wangk2017/krv_m0/(list of files, cad)

Other CAD files:
FPGA_PROGRAMMING_DATA/krv_m.stp
