wangk2017/krv_m0/src/rtl/core/imem_ctrl.v

/*
 Licensed under the Apache License, Version 2.0 (the "License");         
 you may not use this file except in compliance with the License.        
 You may obtain a copy of the License at                                 
                                                                         
     http://www.apache.org/licenses/LICENSE-2.0                          
                                                                         
  Unless required by applicable law or agreed to in writing, software    
 distributed under the License is distributed on an "AS IS" BASIS,       
 WITHOUT WARRANTIES OR CONDITIONS OF ANY KIND, either express or implied.
 See the License for the specific language governing permissions and     
 limitations under the License.      
*/

//==============================================================||
// File Name: 		mem_ctrl.v				||
// Author:    		Kitty Wang				||
// Description: 						||
//	      		instruction memory control block        ||
// History:   							||
//                      2017/9/26 				||
//                      First version				||
//===============================================================

`include "top_defines.vh"
`include "core_defines.vh"
module imem_ctrl (
//global signals
input wire cpu_clk,					//cpu clock
input wire cpu_rstn,					//cpu reset, active low

//interface with fetch
input wire [`ADDR_WIDTH - 1 : 0] next_pc,			//next_pc
input wire [`ADDR_WIDTH - 1 : 0] pc,				//pc
output wire [`INSTR_WIDTH - 1 : 0] instr_read_data,  	//instruction
output wire instr_read_data_valid,			//instruction valid
output wire addr_AHB,

//interface with ITCM
output wire instr_itcm_access,				//ITCM access
output wire [`ADDR_WIDTH - 1 : 0] instr_itcm_addr,	//ITCM access address
input wire [`INSTR_WIDTH - 1 : 0] instr_itcm_read_data,	//ITCM read data
input wire instr_itcm_read_data_valid,			//ITCM read data valid
input wire itcm_auto_load,			//ITCM is in auto-load process

//interface with DTCM
input wire dtcm_en,					//DTCM enable
input wire [`ADDR_WIDTH - 1 : 0] dtcm_start_addr,	//DTCM start address
output instr_dtcm_access,				//DTCM access signal
output [`ADDR_WIDTH - 1 : 0] instr_dtcm_addr,		//DTCM access address
input wire [`DATA_WIDTH - 1 : 0] instr_dtcm_read_data,	//DTCM read data
input wire instr_dtcm_read_data_valid,			//DTCM read data valid

//interface with IAHB
output wire IAHB_access,				//IAHB access 
output wire [`ADDR_WIDTH - 1 : 0] IAHB_addr,		//IAHB access address
input wire [`INSTR_WIDTH - 1 : 0] IAHB_read_data,	//IAHB read data
input wire IAHB_read_data_valid				//IAHB read data valid
);


//NOTE: memory access should be aligned for now!

//---------------------------------------------//
//address decoder
//---------------------------------------------//
wire addr_itcm;
wire addr_dtcm;
assign addr_itcm =(next_pc >= `ITCM_START_ADDR) && (next_pc < `ITCM_START_ADDR + `ITCM_SIZE);
assign addr_dtcm = dtcm_en && ( (next_pc < dtcm_start_addr + `DTCM_SIZE) && (next_pc >= dtcm_start_addr));
assign addr_AHB = ~(addr_itcm | addr_dtcm);

reg addr_itcm_r;
reg addr_dtcm_r;
reg addr_AHB_r;

always @ (posedge cpu_clk or negedge cpu_rstn)
begin
	if(!cpu_rstn)
	begin
		addr_itcm_r <= 1'b0;
		addr_dtcm_r <= 1'b0;
		addr_AHB_r <= 1'b0;
	end
	else
	begin
		addr_itcm_r <= addr_itcm;
		addr_dtcm_r <= addr_dtcm;
		addr_AHB_r <= addr_AHB;
	end
end

//---------------------------------------------//
//Drive interface
//---------------------------------------------//
assign instr_itcm_access = addr_itcm;
assign instr_itcm_addr = next_pc;

assign instr_dtcm_access = addr_dtcm;
assign instr_dtcm_addr = next_pc;

assign IAHB_access = addr_AHB_r;
assign IAHB_addr = pc;
 
//---------------------------------------------//
//read data MUX 
//---------------------------------------------//
assign instr_read_data = ({`INSTR_WIDTH{(addr_itcm_r & instr_itcm_read_data_valid)}} & instr_itcm_read_data)
			|({`INSTR_WIDTH{(addr_dtcm_r & instr_dtcm_read_data_valid)}} & instr_dtcm_read_data) 
			|({`INSTR_WIDTH{(!itcm_auto_load & addr_AHB_r &  IAHB_read_data_valid)}} & IAHB_read_data);
assign instr_read_data_valid = (addr_itcm_r && instr_itcm_read_data_valid) || (addr_dtcm_r && instr_dtcm_read_data_valid) || (!itcm_auto_load && addr_AHB_r && IAHB_read_data_valid);

endmodule
