wangk2017/krv_m0/src/component/work/flash_ss_MSS/flash_ss_MSS_pre.v

`timescale 1 ns/100 ps
// Version: 


module MSS_025(
       CAN_RXBUS_MGPIO3A_H2F_A,
       CAN_RXBUS_MGPIO3A_H2F_B,
       CAN_TX_EBL_MGPIO4A_H2F_A,
       CAN_TX_EBL_MGPIO4A_H2F_B,
       CAN_TXBUS_MGPIO2A_H2F_A,
       CAN_TXBUS_MGPIO2A_H2F_B,
       CLK_CONFIG_APB,
       COMMS_INT,
       CONFIG_PRESET_N,
       EDAC_ERROR,
       F_FM0_RDATA,
       F_FM0_READYOUT,
       F_FM0_RESP,
       F_HM0_ADDR,
       F_HM0_ENABLE,
       F_HM0_SEL,
       F_HM0_SIZE,
       F_HM0_TRANS1,
       F_HM0_WDATA,
       F_HM0_WRITE,
       FAB_CHRGVBUS,
       FAB_DISCHRGVBUS,
       FAB_DMPULLDOWN,
       FAB_DPPULLDOWN,
       FAB_DRVVBUS,
       FAB_IDPULLUP,
       FAB_OPMODE,
       FAB_SUSPENDM,
       FAB_TERMSEL,
       FAB_TXVALID,
       FAB_VCONTROL,
       FAB_VCONTROLLOADM,
       FAB_XCVRSEL,
       FAB_XDATAOUT,
       FACC_GLMUX_SEL,
       FIC32_0_MASTER,
       FIC32_1_MASTER,
       FPGA_RESET_N,
       GTX_CLK,
       H2F_INTERRUPT,
       H2F_NMI,
       H2FCALIB,
       I2C0_SCL_MGPIO31B_H2F_A,
       I2C0_SCL_MGPIO31B_H2F_B,
       I2C0_SDA_MGPIO30B_H2F_A,
       I2C0_SDA_MGPIO30B_H2F_B,
       I2C1_SCL_MGPIO1A_H2F_A,
       I2C1_SCL_MGPIO1A_H2F_B,
       I2C1_SDA_MGPIO0A_H2F_A,
       I2C1_SDA_MGPIO0A_H2F_B,
       MDCF,
       MDOENF,
       MDOF,
       MMUART0_CTS_MGPIO19B_H2F_A,
       MMUART0_CTS_MGPIO19B_H2F_B,
       MMUART0_DCD_MGPIO22B_H2F_A,
       MMUART0_DCD_MGPIO22B_H2F_B,
       MMUART0_DSR_MGPIO20B_H2F_A,
       MMUART0_DSR_MGPIO20B_H2F_B,
       MMUART0_DTR_MGPIO18B_H2F_A,
       MMUART0_DTR_MGPIO18B_H2F_B,
       MMUART0_RI_MGPIO21B_H2F_A,
       MMUART0_RI_MGPIO21B_H2F_B,
       MMUART0_RTS_MGPIO17B_H2F_A,
       MMUART0_RTS_MGPIO17B_H2F_B,
       MMUART0_RXD_MGPIO28B_H2F_A,
       MMUART0_RXD_MGPIO28B_H2F_B,
       MMUART0_SCK_MGPIO29B_H2F_A,
       MMUART0_SCK_MGPIO29B_H2F_B,
       MMUART0_TXD_MGPIO27B_H2F_A,
       MMUART0_TXD_MGPIO27B_H2F_B,
       MMUART1_DTR_MGPIO12B_H2F_A,
       MMUART1_RTS_MGPIO11B_H2F_A,
       MMUART1_RTS_MGPIO11B_H2F_B,
       MMUART1_RXD_MGPIO26B_H2F_A,
       MMUART1_RXD_MGPIO26B_H2F_B,
       MMUART1_SCK_MGPIO25B_H2F_A,
       MMUART1_SCK_MGPIO25B_H2F_B,
       MMUART1_TXD_MGPIO24B_H2F_A,
       MMUART1_TXD_MGPIO24B_H2F_B,
       MPLL_LOCK,
       PER2_FABRIC_PADDR,
       PER2_FABRIC_PENABLE,
       PER2_FABRIC_PSEL,
       PER2_FABRIC_PWDATA,
       PER2_FABRIC_PWRITE,
       RTC_MATCH,
       SLEEPDEEP,
       SLEEPHOLDACK,
       SLEEPING,
       SMBALERT_NO0,
       SMBALERT_NO1,
       SMBSUS_NO0,
       SMBSUS_NO1,
       SPI0_CLK_OUT,
       SPI0_SDI_MGPIO5A_H2F_A,
       SPI0_SDI_MGPIO5A_H2F_B,
       SPI0_SDO_MGPIO6A_H2F_A,
       SPI0_SDO_MGPIO6A_H2F_B,
       SPI0_SS0_MGPIO7A_H2F_A,
       SPI0_SS0_MGPIO7A_H2F_B,
       SPI0_SS1_MGPIO8A_H2F_A,
       SPI0_SS1_MGPIO8A_H2F_B,
       SPI0_SS2_MGPIO9A_H2F_A,
       SPI0_SS2_MGPIO9A_H2F_B,
       SPI0_SS3_MGPIO10A_H2F_A,
       SPI0_SS3_MGPIO10A_H2F_B,
       SPI0_SS4_MGPIO19A_H2F_A,
       SPI0_SS5_MGPIO20A_H2F_A,
       SPI0_SS6_MGPIO21A_H2F_A,
       SPI0_SS7_MGPIO22A_H2F_A,
       SPI1_CLK_OUT,
       SPI1_SDI_MGPIO11A_H2F_A,
       SPI1_SDI_MGPIO11A_H2F_B,
       SPI1_SDO_MGPIO12A_H2F_A,
       SPI1_SDO_MGPIO12A_H2F_B,
       SPI1_SS0_MGPIO13A_H2F_A,
       SPI1_SS0_MGPIO13A_H2F_B,
       SPI1_SS1_MGPIO14A_H2F_A,
       SPI1_SS1_MGPIO14A_H2F_B,
       SPI1_SS2_MGPIO15A_H2F_A,
       SPI1_SS2_MGPIO15A_H2F_B,
       SPI1_SS3_MGPIO16A_H2F_A,
       SPI1_SS3_MGPIO16A_H2F_B,
       SPI1_SS4_MGPIO17A_H2F_A,
       SPI1_SS5_MGPIO18A_H2F_A,
       SPI1_SS6_MGPIO23A_H2F_A,
       SPI1_SS7_MGPIO24A_H2F_A,
       TCGF,
       TRACECLK,
       TRACEDATA,
       TX_CLK,
       TX_ENF,
       TX_ERRF,
       TXCTL_EN_RIF,
       TXD_RIF,
       TXDF,
       TXEV,
       WDOGTIMEOUT,
       F_ARREADY_HREADYOUT1,
       F_AWREADY_HREADYOUT0,
       F_BID,
       F_BRESP_HRESP0,
       F_BVALID,
       F_RDATA_HRDATA01,
       F_RID,
       F_RLAST,
       F_RRESP_HRESP1,
       F_RVALID,
       F_WREADY,
       MDDR_FABRIC_PRDATA,
       MDDR_FABRIC_PREADY,
       MDDR_FABRIC_PSLVERR,
       CAN_RXBUS_F2H_SCP,
       CAN_TX_EBL_F2H_SCP,
       CAN_TXBUS_F2H_SCP,
       COLF,
       CRSF,
       F2_DMAREADY,
       F2H_INTERRUPT,
       F2HCALIB,
       F_DMAREADY,
       F_FM0_ADDR,
       F_FM0_ENABLE,
       F_FM0_MASTLOCK,
       F_FM0_READY,
       F_FM0_SEL,
       F_FM0_SIZE,
       F_FM0_TRANS1,
       F_FM0_WDATA,
       F_FM0_WRITE,
       F_HM0_RDATA,
       F_HM0_READY,
       F_HM0_RESP,
       FAB_AVALID,
       FAB_HOSTDISCON,
       FAB_IDDIG,
       FAB_LINESTATE,
       FAB_M3_RESET_N,
       FAB_PLL_LOCK,
       FAB_RXACTIVE,
       FAB_RXERROR,
       FAB_RXVALID,
       FAB_RXVALIDH,
       FAB_SESSEND,
       FAB_TXREADY,
       FAB_VBUSVALID,
       FAB_VSTATUS,
       FAB_XDATAIN,
       GTX_CLKPF,
       I2C0_BCLK,
       I2C0_SCL_F2H_SCP,
       I2C0_SDA_F2H_SCP,
       I2C1_BCLK,
       I2C1_SCL_F2H_SCP,
       I2C1_SDA_F2H_SCP,
       MDIF,
       MGPIO0A_F2H_GPIN,
       MGPIO10A_F2H_GPIN,
       MGPIO11A_F2H_GPIN,
       MGPIO11B_F2H_GPIN,
       MGPIO12A_F2H_GPIN,
       MGPIO13A_F2H_GPIN,
       MGPIO14A_F2H_GPIN,
       MGPIO15A_F2H_GPIN,
       MGPIO16A_F2H_GPIN,
       MGPIO17B_F2H_GPIN,
       MGPIO18B_F2H_GPIN,
       MGPIO19B_F2H_GPIN,
       MGPIO1A_F2H_GPIN,
       MGPIO20B_F2H_GPIN,
       MGPIO21B_F2H_GPIN,
       MGPIO22B_F2H_GPIN,
       MGPIO24B_F2H_GPIN,
       MGPIO25B_F2H_GPIN,
       MGPIO26B_F2H_GPIN,
       MGPIO27B_F2H_GPIN,
       MGPIO28B_F2H_GPIN,
       MGPIO29B_F2H_GPIN,
       MGPIO2A_F2H_GPIN,
       MGPIO30B_F2H_GPIN,
       MGPIO31B_F2H_GPIN,
       MGPIO3A_F2H_GPIN,
       MGPIO4A_F2H_GPIN,
       MGPIO5A_F2H_GPIN,
       MGPIO6A_F2H_GPIN,
       MGPIO7A_F2H_GPIN,
       MGPIO8A_F2H_GPIN,
       MGPIO9A_F2H_GPIN,
       MMUART0_CTS_F2H_SCP,
       MMUART0_DCD_F2H_SCP,
       MMUART0_DSR_F2H_SCP,
       MMUART0_DTR_F2H_SCP,
       MMUART0_RI_F2H_SCP,
       MMUART0_RTS_F2H_SCP,
       MMUART0_RXD_F2H_SCP,
       MMUART0_SCK_F2H_SCP,
       MMUART0_TXD_F2H_SCP,
       MMUART1_CTS_F2H_SCP,
       MMUART1_DCD_F2H_SCP,
       MMUART1_DSR_F2H_SCP,
       MMUART1_RI_F2H_SCP,
       MMUART1_RTS_F2H_SCP,
       MMUART1_RXD_F2H_SCP,
       MMUART1_SCK_F2H_SCP,
       MMUART1_TXD_F2H_SCP,
       PER2_FABRIC_PRDATA,
       PER2_FABRIC_PREADY,
       PER2_FABRIC_PSLVERR,
       RCGF,
       RX_CLKPF,
       RX_DVF,
       RX_ERRF,
       RX_EV,
       RXDF,
       SLEEPHOLDREQ,
       SMBALERT_NI0,
       SMBALERT_NI1,
       SMBSUS_NI0,
       SMBSUS_NI1,
       SPI0_CLK_IN,
       SPI0_SDI_F2H_SCP,
       SPI0_SDO_F2H_SCP,
       SPI0_SS0_F2H_SCP,
       SPI0_SS1_F2H_SCP,
       SPI0_SS2_F2H_SCP,
       SPI0_SS3_F2H_SCP,
       SPI1_CLK_IN,
       SPI1_SDI_F2H_SCP,
       SPI1_SDO_F2H_SCP,
       SPI1_SS0_F2H_SCP,
       SPI1_SS1_F2H_SCP,
       SPI1_SS2_F2H_SCP,
       SPI1_SS3_F2H_SCP,
       TX_CLKPF,
       USER_MSS_GPIO_RESET_N,
       USER_MSS_RESET_N,
       XCLK_FAB,
       CLK_BASE,
       CLK_MDDR_APB,
       F_ARADDR_HADDR1,
       F_ARBURST_HTRANS1,
       F_ARID_HSEL1,
       F_ARLEN_HBURST1,
       F_ARLOCK_HMASTLOCK1,
       F_ARSIZE_HSIZE1,
       F_ARVALID_HWRITE1,
       F_AWADDR_HADDR0,
       F_AWBURST_HTRANS0,
       F_AWID_HSEL0,
       F_AWLEN_HBURST0,
       F_AWLOCK_HMASTLOCK0,
       F_AWSIZE_HSIZE0,
       F_AWVALID_HWRITE0,
       F_BREADY,
       F_RMW_AXI,
       F_RREADY,
       F_WDATA_HWDATA01,
       F_WID_HREADY01,
       F_WLAST,
       F_WSTRB,
       F_WVALID,
       FPGA_MDDR_ARESET_N,
       MDDR_FABRIC_PADDR,
       MDDR_FABRIC_PENABLE,
       MDDR_FABRIC_PSEL,
       MDDR_FABRIC_PWDATA,
       MDDR_FABRIC_PWRITE,
       PRESET_N,
       CAN_RXBUS_USBA_DATA1_MGPIO3A_IN,
       CAN_TX_EBL_USBA_DATA2_MGPIO4A_IN,
       CAN_TXBUS_USBA_DATA0_MGPIO2A_IN,
       DM_IN,
       DRAM_DQ_IN,
       DRAM_DQS_IN,
       DRAM_FIFO_WE_IN,
       I2C0_SCL_USBC_DATA1_MGPIO31B_IN,
       I2C0_SDA_USBC_DATA0_MGPIO30B_IN,
       I2C1_SCL_USBA_DATA4_MGPIO1A_IN,
       I2C1_SDA_USBA_DATA3_MGPIO0A_IN,
       MGPIO25A_IN,
       MGPIO26A_IN,
       MMUART0_CTS_USBC_DATA7_MGPIO19B_IN,
       MMUART0_DCD_MGPIO22B_IN,
       MMUART0_DSR_MGPIO20B_IN,
       MMUART0_DTR_USBC_DATA6_MGPIO18B_IN,
       MMUART0_RI_MGPIO21B_IN,
       MMUART0_RTS_USBC_DATA5_MGPIO17B_IN,
       MMUART0_RXD_USBC_STP_MGPIO28B_IN,
       MMUART0_SCK_USBC_NXT_MGPIO29B_IN,
       MMUART0_TXD_USBC_DIR_MGPIO27B_IN,
       MMUART1_CTS_MGPIO13B_IN,
       MMUART1_DCD_MGPIO16B_IN,
       MMUART1_DSR_MGPIO14B_IN,
       MMUART1_DTR_MGPIO12B_IN,
       MMUART1_RI_MGPIO15B_IN,
       MMUART1_RTS_MGPIO11B_IN,
       MMUART1_RXD_USBC_DATA3_MGPIO26B_IN,
       MMUART1_SCK_USBC_DATA4_MGPIO25B_IN,
       MMUART1_TXD_USBC_DATA2_MGPIO24B_IN,
       RGMII_GTX_CLK_RMII_CLK_USBB_XCLK_IN,
       RGMII_MDC_RMII_MDC_IN,
       RGMII_MDIO_RMII_MDIO_USBB_DATA7_IN,
       RGMII_RX_CLK_IN,
       RGMII_RX_CTL_RMII_CRS_DV_USBB_DATA2_IN,
       RGMII_RXD0_RMII_RXD0_USBB_DATA0_IN,
       RGMII_RXD1_RMII_RXD1_USBB_DATA1_IN,
       RGMII_RXD2_RMII_RX_ER_USBB_DATA3_IN,
       RGMII_RXD3_USBB_DATA4_IN,
       RGMII_TX_CLK_IN,
       RGMII_TX_CTL_RMII_TX_EN_USBB_NXT_IN,
       RGMII_TXD0_RMII_TXD0_USBB_DIR_IN,
       RGMII_TXD1_RMII_TXD1_USBB_STP_IN,
       RGMII_TXD2_USBB_DATA5_IN,
       RGMII_TXD3_USBB_DATA6_IN,
       SPI0_SCK_USBA_XCLK_IN,
       SPI0_SDI_USBA_DIR_MGPIO5A_IN,
       SPI0_SDO_USBA_STP_MGPIO6A_IN,
       SPI0_SS0_USBA_NXT_MGPIO7A_IN,
       SPI0_SS1_USBA_DATA5_MGPIO8A_IN,
       SPI0_SS2_USBA_DATA6_MGPIO9A_IN,
       SPI0_SS3_USBA_DATA7_MGPIO10A_IN,
       SPI0_SS4_MGPIO19A_IN,
       SPI0_SS5_MGPIO20A_IN,
       SPI0_SS6_MGPIO21A_IN,
       SPI0_SS7_MGPIO22A_IN,
       SPI1_SCK_IN,
       SPI1_SDI_MGPIO11A_IN,
       SPI1_SDO_MGPIO12A_IN,
       SPI1_SS0_MGPIO13A_IN,
       SPI1_SS1_MGPIO14A_IN,
       SPI1_SS2_MGPIO15A_IN,
       SPI1_SS3_MGPIO16A_IN,
       SPI1_SS4_MGPIO17A_IN,
       SPI1_SS5_MGPIO18A_IN,
       SPI1_SS6_MGPIO23A_IN,
       SPI1_SS7_MGPIO24A_IN,
       USBC_XCLK_IN,
       CAN_RXBUS_USBA_DATA1_MGPIO3A_OUT,
       CAN_TX_EBL_USBA_DATA2_MGPIO4A_OUT,
       CAN_TXBUS_USBA_DATA0_MGPIO2A_OUT,
       DRAM_ADDR,
       DRAM_BA,
       DRAM_CASN,
       DRAM_CKE,
       DRAM_CLK,
       DRAM_CSN,
       DRAM_DM_RDQS_OUT,
       DRAM_DQ_OUT,
       DRAM_DQS_OUT,
       DRAM_FIFO_WE_OUT,
       DRAM_ODT,
       DRAM_RASN,
       DRAM_RSTN,
       DRAM_WEN,
       I2C0_SCL_USBC_DATA1_MGPIO31B_OUT,
       I2C0_SDA_USBC_DATA0_MGPIO30B_OUT,
       I2C1_SCL_USBA_DATA4_MGPIO1A_OUT,
       I2C1_SDA_USBA_DATA3_MGPIO0A_OUT,
       MGPIO25A_OUT,
       MGPIO26A_OUT,
       MMUART0_CTS_USBC_DATA7_MGPIO19B_OUT,
       MMUART0_DCD_MGPIO22B_OUT,
       MMUART0_DSR_MGPIO20B_OUT,
       MMUART0_DTR_USBC_DATA6_MGPIO18B_OUT,
       MMUART0_RI_MGPIO21B_OUT,
       MMUART0_RTS_USBC_DATA5_MGPIO17B_OUT,
       MMUART0_RXD_USBC_STP_MGPIO28B_OUT,
       MMUART0_SCK_USBC_NXT_MGPIO29B_OUT,
       MMUART0_TXD_USBC_DIR_MGPIO27B_OUT,
       MMUART1_CTS_MGPIO13B_OUT,
       MMUART1_DCD_MGPIO16B_OUT,
       MMUART1_DSR_MGPIO14B_OUT,
       MMUART1_DTR_MGPIO12B_OUT,
       MMUART1_RI_MGPIO15B_OUT,
       MMUART1_RTS_MGPIO11B_OUT,
       MMUART1_RXD_USBC_DATA3_MGPIO26B_OUT,
       MMUART1_SCK_USBC_DATA4_MGPIO25B_OUT,
       MMUART1_TXD_USBC_DATA2_MGPIO24B_OUT,
       RGMII_GTX_CLK_RMII_CLK_USBB_XCLK_OUT,
       RGMII_MDC_RMII_MDC_OUT,
       RGMII_MDIO_RMII_MDIO_USBB_DATA7_OUT,
       RGMII_RX_CLK_OUT,
       RGMII_RX_CTL_RMII_CRS_DV_USBB_DATA2_OUT,
       RGMII_RXD0_RMII_RXD0_USBB_DATA0_OUT,
       RGMII_RXD1_RMII_RXD1_USBB_DATA1_OUT,
       RGMII_RXD2_RMII_RX_ER_USBB_DATA3_OUT,
       RGMII_RXD3_USBB_DATA4_OUT,
       RGMII_TX_CLK_OUT,
       RGMII_TX_CTL_RMII_TX_EN_USBB_NXT_OUT,
       RGMII_TXD0_RMII_TXD0_USBB_DIR_OUT,
       RGMII_TXD1_RMII_TXD1_USBB_STP_OUT,
       RGMII_TXD2_USBB_DATA5_OUT,
       RGMII_TXD3_USBB_DATA6_OUT,
       SPI0_SCK_USBA_XCLK_OUT,
       SPI0_SDI_USBA_DIR_MGPIO5A_OUT,
       SPI0_SDO_USBA_STP_MGPIO6A_OUT,
       SPI0_SS0_USBA_NXT_MGPIO7A_OUT,
       SPI0_SS1_USBA_DATA5_MGPIO8A_OUT,
       SPI0_SS2_USBA_DATA6_MGPIO9A_OUT,
       SPI0_SS3_USBA_DATA7_MGPIO10A_OUT,
       SPI0_SS4_MGPIO19A_OUT,
       SPI0_SS5_MGPIO20A_OUT,
       SPI0_SS6_MGPIO21A_OUT,
       SPI0_SS7_MGPIO22A_OUT,
       SPI1_SCK_OUT,
       SPI1_SDI_MGPIO11A_OUT,
       SPI1_SDO_MGPIO12A_OUT,
       SPI1_SS0_MGPIO13A_OUT,
       SPI1_SS1_MGPIO14A_OUT,
       SPI1_SS2_MGPIO15A_OUT,
       SPI1_SS3_MGPIO16A_OUT,
       SPI1_SS4_MGPIO17A_OUT,
       SPI1_SS5_MGPIO18A_OUT,
       SPI1_SS6_MGPIO23A_OUT,
       SPI1_SS7_MGPIO24A_OUT,
       USBC_XCLK_OUT,
       CAN_RXBUS_USBA_DATA1_MGPIO3A_OE,
       CAN_TX_EBL_USBA_DATA2_MGPIO4A_OE,
       CAN_TXBUS_USBA_DATA0_MGPIO2A_OE,
       DM_OE,
       DRAM_DQ_OE,
       DRAM_DQS_OE,
       I2C0_SCL_USBC_DATA1_MGPIO31B_OE,
       I2C0_SDA_USBC_DATA0_MGPIO30B_OE,
       I2C1_SCL_USBA_DATA4_MGPIO1A_OE,
       I2C1_SDA_USBA_DATA3_MGPIO0A_OE,
       MGPIO25A_OE,
       MGPIO26A_OE,
       MMUART0_CTS_USBC_DATA7_MGPIO19B_OE,
       MMUART0_DCD_MGPIO22B_OE,
       MMUART0_DSR_MGPIO20B_OE,
       MMUART0_DTR_USBC_DATA6_MGPIO18B_OE,
       MMUART0_RI_MGPIO21B_OE,
       MMUART0_RTS_USBC_DATA5_MGPIO17B_OE,
       MMUART0_RXD_USBC_STP_MGPIO28B_OE,
       MMUART0_SCK_USBC_NXT_MGPIO29B_OE,
       MMUART0_TXD_USBC_DIR_MGPIO27B_OE,
       MMUART1_CTS_MGPIO13B_OE,
       MMUART1_DCD_MGPIO16B_OE,
       MMUART1_DSR_MGPIO14B_OE,
       MMUART1_DTR_MGPIO12B_OE,
       MMUART1_RI_MGPIO15B_OE,
       MMUART1_RTS_MGPIO11B_OE,
       MMUART1_RXD_USBC_DATA3_MGPIO26B_OE,
       MMUART1_SCK_USBC_DATA4_MGPIO25B_OE,
       MMUART1_TXD_USBC_DATA2_MGPIO24B_OE,
       RGMII_GTX_CLK_RMII_CLK_USBB_XCLK_OE,
       RGMII_MDC_RMII_MDC_OE,
       RGMII_MDIO_RMII_MDIO_USBB_DATA7_OE,
       RGMII_RX_CLK_OE,
       RGMII_RX_CTL_RMII_CRS_DV_USBB_DATA2_OE,
       RGMII_RXD0_RMII_RXD0_USBB_DATA0_OE,
       RGMII_RXD1_RMII_RXD1_USBB_DATA1_OE,
       RGMII_RXD2_RMII_RX_ER_USBB_DATA3_OE,
       RGMII_RXD3_USBB_DATA4_OE,
       RGMII_TX_CLK_OE,
       RGMII_TX_CTL_RMII_TX_EN_USBB_NXT_OE,
       RGMII_TXD0_RMII_TXD0_USBB_DIR_OE,
       RGMII_TXD1_RMII_TXD1_USBB_STP_OE,
       RGMII_TXD2_USBB_DATA5_OE,
       RGMII_TXD3_USBB_DATA6_OE,
       SPI0_SCK_USBA_XCLK_OE,
       SPI0_SDI_USBA_DIR_MGPIO5A_OE,
       SPI0_SDO_USBA_STP_MGPIO6A_OE,
       SPI0_SS0_USBA_NXT_MGPIO7A_OE,
       SPI0_SS1_USBA_DATA5_MGPIO8A_OE,
       SPI0_SS2_USBA_DATA6_MGPIO9A_OE,
       SPI0_SS3_USBA_DATA7_MGPIO10A_OE,
       SPI0_SS4_MGPIO19A_OE,
       SPI0_SS5_MGPIO20A_OE,
       SPI0_SS6_MGPIO21A_OE,
       SPI0_SS7_MGPIO22A_OE,
       SPI1_SCK_OE,
       SPI1_SDI_MGPIO11A_OE,
       SPI1_SDO_MGPIO12A_OE,
       SPI1_SS0_MGPIO13A_OE,
       SPI1_SS1_MGPIO14A_OE,
       SPI1_SS2_MGPIO15A_OE,
       SPI1_SS3_MGPIO16A_OE,
       SPI1_SS4_MGPIO17A_OE,
       SPI1_SS5_MGPIO18A_OE,
       SPI1_SS6_MGPIO23A_OE,
       SPI1_SS7_MGPIO24A_OE,
       USBC_XCLK_OE
    )
/* synthesis black_box

pragma attribute MSS_025 ment_tsu0 CAN_RXBUS_F2H_SCP->CLK_BASE+1.470
pragma attribute MSS_025 ment_tsu1 F2HCALIB->CLK_BASE+1.317
pragma attribute MSS_025 ment_tsu2 F2H_INTERRUPT[0]->CLK_BASE+0.961
pragma attribute MSS_025 ment_tsu3 F2H_INTERRUPT[10]->CLK_BASE+1.091
pragma attribute MSS_025 ment_tsu4 F2H_INTERRUPT[11]->CLK_BASE+1.027
pragma attribute MSS_025 ment_tsu5 F2H_INTERRUPT[12]->CLK_BASE+1.013
pragma attribute MSS_025 ment_tsu6 F2H_INTERRUPT[13]->CLK_BASE+0.996
pragma attribute MSS_025 ment_tsu7 F2H_INTERRUPT[14]->CLK_BASE+1.027
pragma attribute MSS_025 ment_tsu8 F2H_INTERRUPT[15]->CLK_BASE+0.999
pragma attribute MSS_025 ment_tsu9 F2H_INTERRUPT[1]->CLK_BASE+0.968
pragma attribute MSS_025 ment_tsu10 F2H_INTERRUPT[2]->CLK_BASE+1.029
pragma attribute MSS_025 ment_tsu11 F2H_INTERRUPT[3]->CLK_BASE+0.962
pragma attribute MSS_025 ment_tsu12 F2H_INTERRUPT[4]->CLK_BASE+1.009
pragma attribute MSS_025 ment_tsu13 F2H_INTERRUPT[5]->CLK_BASE+1.048
pragma attribute MSS_025 ment_tsu14 F2H_INTERRUPT[6]->CLK_BASE+0.999
pragma attribute MSS_025 ment_tsu15 F2H_INTERRUPT[7]->CLK_BASE+0.994
pragma attribute MSS_025 ment_tsu16 F2H_INTERRUPT[8]->CLK_BASE+1.030
pragma attribute MSS_025 ment_tsu17 F2H_INTERRUPT[9]->CLK_BASE+0.985
pragma attribute MSS_025 ment_tsu18 F_FM0_ADDR[0]->CLK_BASE+0.966
pragma attribute MSS_025 ment_tsu19 F_FM0_ADDR[10]->CLK_BASE+0.996
pragma attribute MSS_025 ment_tsu20 F_FM0_ADDR[11]->CLK_BASE+1.020
pragma attribute MSS_025 ment_tsu21 F_FM0_ADDR[12]->CLK_BASE+1.051
pragma attribute MSS_025 ment_tsu22 F_FM0_ADDR[13]->CLK_BASE+1.148
pragma attribute MSS_025 ment_tsu23 F_FM0_ADDR[14]->CLK_BASE+1.033
pragma attribute MSS_025 ment_tsu24 F_FM0_ADDR[15]->CLK_BASE+1.147
pragma attribute MSS_025 ment_tsu25 F_FM0_ADDR[16]->CLK_BASE+1.022
pragma attribute MSS_025 ment_tsu26 F_FM0_ADDR[17]->CLK_BASE+0.593
pragma attribute MSS_025 ment_tsu27 F_FM0_ADDR[18]->CLK_BASE+0.782
pragma attribute MSS_025 ment_tsu28 F_FM0_ADDR[19]->CLK_BASE+0.567
pragma attribute MSS_025 ment_tsu29 F_FM0_ADDR[1]->CLK_BASE+0.987
pragma attribute MSS_025 ment_tsu30 F_FM0_ADDR[20]->CLK_BASE+0.589
pragma attribute MSS_025 ment_tsu31 F_FM0_ADDR[21]->CLK_BASE+0.540
pragma attribute MSS_025 ment_tsu32 F_FM0_ADDR[22]->CLK_BASE+0.586
pragma attribute MSS_025 ment_tsu33 F_FM0_ADDR[23]->CLK_BASE+0.601
pragma attribute MSS_025 ment_tsu34 F_FM0_ADDR[24]->CLK_BASE+0.595
pragma attribute MSS_025 ment_tsu35 F_FM0_ADDR[25]->CLK_BASE+0.685
pragma attribute MSS_025 ment_tsu36 F_FM0_ADDR[26]->CLK_BASE+0.727
pragma attribute MSS_025 ment_tsu37 F_FM0_ADDR[27]->CLK_BASE+0.742
pragma attribute MSS_025 ment_tsu38 F_FM0_ADDR[28]->CLK_BASE+0.736
pragma attribute MSS_025 ment_tsu39 F_FM0_ADDR[29]->CLK_BASE+0.558
pragma attribute MSS_025 ment_tsu40 F_FM0_ADDR[2]->CLK_BASE+0.398
pragma attribute MSS_025 ment_tsu41 F_FM0_ADDR[30]->CLK_BASE+0.660
pragma attribute MSS_025 ment_tsu42 F_FM0_ADDR[31]->CLK_BASE+0.579
pragma attribute MSS_025 ment_tsu43 F_FM0_ADDR[3]->CLK_BASE+1.001
pragma attribute MSS_025 ment_tsu44 F_FM0_ADDR[4]->CLK_BASE+1.004
pragma attribute MSS_025 ment_tsu45 F_FM0_ADDR[5]->CLK_BASE+0.934
pragma attribute MSS_025 ment_tsu46 F_FM0_ADDR[6]->CLK_BASE+0.984
pragma attribute MSS_025 ment_tsu47 F_FM0_ADDR[7]->CLK_BASE+1.006
pragma attribute MSS_025 ment_tsu48 F_FM0_ADDR[8]->CLK_BASE+1.021
pragma attribute MSS_025 ment_tsu49 F_FM0_ADDR[9]->CLK_BASE+1.048
pragma attribute MSS_025 ment_tsu50 F_FM0_MASTLOCK->CLK_BASE+0.564
pragma attribute MSS_025 ment_tsu51 F_FM0_READY->CLK_BASE+0.698
pragma attribute MSS_025 ment_tsu52 F_FM0_SEL->CLK_BASE+1.125
pragma attribute MSS_025 ment_tsu53 F_FM0_SIZE[0]->CLK_BASE+0.381
pragma attribute MSS_025 ment_tsu54 F_FM0_SIZE[1]->CLK_BASE+0.438
pragma attribute MSS_025 ment_tsu55 F_FM0_TRANS1->CLK_BASE+0.726
pragma attribute MSS_025 ment_tsu56 F_FM0_WDATA[0]->CLK_BASE+0.493
pragma attribute MSS_025 ment_tsu57 F_FM0_WDATA[10]->CLK_BASE+0.361
pragma attribute MSS_025 ment_tsu58 F_FM0_WDATA[11]->CLK_BASE+0.393
pragma attribute MSS_025 ment_tsu59 F_FM0_WDATA[12]->CLK_BASE+0.404
pragma attribute MSS_025 ment_tsu60 F_FM0_WDATA[13]->CLK_BASE+0.477
pragma attribute MSS_025 ment_tsu61 F_FM0_WDATA[14]->CLK_BASE+0.670
pragma attribute MSS_025 ment_tsu62 F_FM0_WDATA[15]->CLK_BASE+0.432
pragma attribute MSS_025 ment_tsu63 F_FM0_WDATA[16]->CLK_BASE+0.425
pragma attribute MSS_025 ment_tsu64 F_FM0_WDATA[17]->CLK_BASE+0.554
pragma attribute MSS_025 ment_tsu65 F_FM0_WDATA[18]->CLK_BASE+0.546
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
pragma attribute MSS_025 ment_tco78 CLK_BASE->F_HM0_WDATA[0]+3.170
pragma attribute MSS_025 ment_tco79 CLK_BASE->F_HM0_WDATA[10]+3.311
pragma attribute MSS_025 ment_tco80 CLK_BASE->F_HM0_WDATA[11]+3.361
pragma attribute MSS_025 ment_tco81 CLK_BASE->F_HM0_WDATA[12]+3.298
pragma attribute MSS_025 ment_tco82 CLK_BASE->F_HM0_WDATA[13]+3.446
pragma attribute MSS_025 ment_tco83 CLK_BASE->F_HM0_WDATA[14]+3.230
pragma attribute MSS_025 ment_tco84 CLK_BASE->F_HM0_WDATA[15]+3.356
pragma attribute MSS_025 ment_tco85 CLK_BASE->F_HM0_WDATA[16]+3.330
pragma attribute MSS_025 ment_tco86 CLK_BASE->F_HM0_WDATA[17]+3.371
pragma attribute MSS_025 ment_tco87 CLK_BASE->F_HM0_WDATA[18]+3.302
pragma attribute MSS_025 ment_tco88 CLK_BASE->F_HM0_WDATA[19]+3.431
pragma attribute MSS_025 ment_tco89 CLK_BASE->F_HM0_WDATA[1]+3.176
pragma attribute MSS_025 ment_tco90 CLK_BASE->F_HM0_WDATA[20]+3.304
pragma attribute MSS_025 ment_tco91 CLK_BASE->F_HM0_WDATA[21]+3.422
pragma attribute MSS_025 ment_tco92 CLK_BASE->F_HM0_WDATA[22]+3.386
pragma attribute MSS_025 ment_tco93 CLK_BASE->F_HM0_WDATA[23]+3.099
pragma attribute MSS_025 ment_tco94 CLK_BASE->F_HM0_WDATA[24]+3.293
pragma attribute MSS_025 ment_tco95 CLK_BASE->F_HM0_WDATA[25]+3.447
pragma attribute MSS_025 ment_tco96 CLK_BASE->F_HM0_WDATA[26]+3.480
pragma attribute MSS_025 ment_tco97 CLK_BASE->F_HM0_WDATA[27]+3.444
pragma attribute MSS_025 ment_tco98 CLK_BASE->F_HM0_WDATA[28]+3.418
pragma attribute MSS_025 ment_tco99 CLK_BASE->F_HM0_WDATA[29]+3.478
pragma attribute MSS_025 ment_tco100 CLK_BASE->F_HM0_WDATA[2]+3.256
pragma attribute MSS_025 ment_tco101 CLK_BASE->F_HM0_WDATA[30]+3.531
pragma attribute MSS_025 ment_tco102 CLK_BASE->F_HM0_WDATA[31]+3.483
pragma attribute MSS_025 ment_tco103 CLK_BASE->F_HM0_WDATA[3]+3.114
pragma attribute MSS_025 ment_tco104 CLK_BASE->F_HM0_WDATA[4]+3.310
pragma attribute MSS_025 ment_tco105 CLK_BASE->F_HM0_WDATA[5]+3.299
pragma attribute MSS_025 ment_tco106 CLK_BASE->F_HM0_WDATA[6]+3.386
pragma attribute MSS_025 ment_tco107 CLK_BASE->F_HM0_WDATA[7]+3.393
pragma attribute MSS_025 ment_tco108 CLK_BASE->F_HM0_WDATA[8]+3.399
pragma attribute MSS_025 ment_tco109 CLK_BASE->F_HM0_WDATA[9]+3.388
pragma attribute MSS_025 ment_tco110 CLK_BASE->F_HM0_WRITE+3.628
pragma attribute MSS_025 ment_tco111 CLK_BASE->H2FCALIB+3.101
pragma attribute MSS_025 ment_tco112 CLK_BASE->I2C0_SCL_MGPIO31B_H2F_B+3.461
pragma attribute MSS_025 ment_tco113 CLK_BASE->I2C0_SCL_USBC_DATA1_MGPIO31B_OE+3.462
pragma attribute MSS_025 ment_tco114 CLK_BASE->I2C0_SDA_MGPIO30B_H2F_A+3.507
pragma attribute MSS_025 ment_tco115 CLK_BASE->I2C0_SDA_MGPIO30B_H2F_B+3.405
pragma attribute MSS_025 ment_tco116 CLK_BASE->I2C0_SDA_USBC_DATA0_MGPIO30B_OE+2.892
pragma attribute MSS_025 ment_tco117 CLK_BASE->I2C1_SCL_MGPIO1A_H2F_B+3.412
pragma attribute MSS_025 ment_tco118 CLK_BASE->I2C1_SCL_USBA_DATA4_MGPIO1A_OE+3.434
pragma attribute MSS_025 ment_tco119 CLK_BASE->I2C1_SDA_MGPIO0A_H2F_A+3.354
pragma attribute MSS_025 ment_tco120 CLK_BASE->I2C1_SDA_MGPIO0A_H2F_B+3.505
pragma attribute MSS_025 ment_tco121 CLK_BASE->I2C1_SDA_USBA_DATA3_MGPIO0A_OE+3.338
pragma attribute MSS_025 ment_tco122 CLK_BASE->MGPIO25A_OE+2.796
pragma attribute MSS_025 ment_tco123 CLK_BASE->MGPIO25A_OUT+2.714
pragma attribute MSS_025 ment_tco124 CLK_BASE->MGPIO26A_OE+2.752
pragma attribute MSS_025 ment_tco125 CLK_BASE->MGPIO26A_OUT+2.837
pragma attribute MSS_025 ment_tco126 CLK_BASE->MMUART0_CTS_MGPIO19B_H2F_A+3.371
pragma attribute MSS_025 ment_tco127 CLK_BASE->MMUART0_CTS_MGPIO19B_H2F_B+3.512
pragma attribute MSS_025 ment_tco128 CLK_BASE->MMUART0_DCD_MGPIO22B_H2F_A+3.236
pragma attribute MSS_025 ment_tco129 CLK_BASE->MMUART0_DCD_MGPIO22B_H2F_B+3.402
pragma attribute MSS_025 ment_tco130 CLK_BASE->MMUART0_DSR_MGPIO20B_H2F_A+3.263
pragma attribute MSS_025 ment_tco131 CLK_BASE->MMUART0_DSR_MGPIO20B_H2F_B+3.450
pragma attribute MSS_025 ment_tco132 CLK_BASE->MMUART0_DTR_MGPIO18B_H2F_A+3.241
pragma attribute MSS_025 ment_tco133 CLK_BASE->MMUART0_DTR_MGPIO18B_H2F_B+3.368
pragma attribute MSS_025 ment_tco134 CLK_BASE->MMUART0_DTR_USBC_DATA6_MGPIO18B_OUT+2.834
pragma attribute MSS_025 ment_tco135 CLK_BASE->MMUART0_RI_MGPIO21B_H2F_A+3.459
pragma attribute MSS_025 ment_tco136 CLK_BASE->MMUART0_RI_MGPIO21B_H2F_B+3.419
pragma attribute MSS_025 ment_tco137 CLK_BASE->MMUART0_RTS_MGPIO17B_H2F_A+3.450
pragma attribute MSS_025 ment_tco138 CLK_BASE->MMUART0_RTS_MGPIO17B_H2F_B+3.406
pragma attribute MSS_025 ment_tco139 CLK_BASE->MMUART0_RTS_USBC_DATA5_MGPIO17B_OUT+2.950
pragma attribute MSS_025 ment_tco140 CLK_BASE->MMUART0_RXD_MGPIO28B_H2F_A+3.514
pragma attribute MSS_025 ment_tco141 CLK_BASE->MMUART0_RXD_MGPIO28B_H2F_B+3.434
pragma attribute MSS_025 ment_tco142 CLK_BASE->MMUART0_SCK_MGPIO29B_H2F_A+3.289
pragma attribute MSS_025 ment_tco143 CLK_BASE->MMUART0_SCK_MGPIO29B_H2F_B+3.407
pragma attribute MSS_025 ment_tco144 CLK_BASE->MMUART0_SCK_USBC_NXT_MGPIO29B_OE+3.181
pragma attribute MSS_025 ment_tco145 CLK_BASE->MMUART0_SCK_USBC_NXT_MGPIO29B_OUT+2.738
pragma attribute MSS_025 ment_tco146 CLK_BASE->MMUART0_TXD_MGPIO27B_H2F_A+3.507
pragma attribute MSS_025 ment_tco147 CLK_BASE->MMUART0_TXD_MGPIO27B_H2F_B+3.404
pragma attribute MSS_025 ment_tco148 CLK_BASE->MMUART0_TXD_USBC_DIR_MGPIO27B_OE+3.439
pragma attribute MSS_025 ment_tco149 CLK_BASE->MMUART0_TXD_USBC_DIR_MGPIO27B_OUT+2.938
pragma attribute MSS_025 ment_tco150 CLK_BASE->MMUART1_DTR_MGPIO12B_H2F_A+3.359
pragma attribute MSS_025 ment_tco151 CLK_BASE->MMUART1_DTR_MGPIO12B_OUT+3.084
pragma attribute MSS_025 ment_tco152 CLK_BASE->MMUART1_RTS_MGPIO11B_H2F_A+3.350
pragma attribute MSS_025 ment_tco153 CLK_BASE->MMUART1_RTS_MGPIO11B_H2F_B+3.401
pragma attribute MSS_025 ment_tco154 CLK_BASE->MMUART1_RTS_MGPIO11B_OUT+3.048
pragma attribute MSS_025 ment_tco155 CLK_BASE->MMUART1_RXD_MGPIO26B_H2F_A+3.474
pragma attribute MSS_025 ment_tco156 CLK_BASE->MMUART1_RXD_MGPIO26B_H2F_B+3.183
pragma attribute MSS_025 ment_tco157 CLK_BASE->MMUART1_SCK_MGPIO25B_H2F_A+3.283
pragma attribute MSS_025 ment_tco158 CLK_BASE->MMUART1_SCK_MGPIO25B_H2F_B+3.474
pragma attribute MSS_025 ment_tco159 CLK_BASE->MMUART1_SCK_USBC_DATA4_MGPIO25B_OE+3.652
pragma attribute MSS_025 ment_tco160 CLK_BASE->MMUART1_SCK_USBC_DATA4_MGPIO25B_OUT+2.702
pragma attribute MSS_025 ment_tco161 CLK_BASE->MMUART1_TXD_MGPIO24B_H2F_A+3.431
pragma attribute MSS_025 ment_tco162 CLK_BASE->MMUART1_TXD_MGPIO24B_H2F_B+4.408
pragma attribute MSS_025 ment_tco163 CLK_BASE->MMUART1_TXD_USBC_DATA2_MGPIO24B_OE+3.431
pragma attribute MSS_025 ment_tco164 CLK_BASE->MMUART1_TXD_USBC_DATA2_MGPIO24B_OUT+3.287
pragma attribute MSS_025 ment_tco165 CLK_BASE->RGMII_MDIO_RMII_MDIO_USBB_DATA7_OE+3.917
pragma attribute MSS_025 ment_tco166 CLK_BASE->RGMII_MDIO_RMII_MDIO_USBB_DATA7_OUT+4.161
pragma attribute MSS_025 ment_tco167 CLK_BASE->SPI0_SDI_MGPIO5A_H2F_A+3.513
pragma attribute MSS_025 ment_tco168 CLK_BASE->SPI0_SDI_MGPIO5A_H2F_B+3.511
pragma attribute MSS_025 ment_tco169 CLK_BASE->SPI0_SDO_MGPIO6A_H2F_A+3.581
pragma attribute MSS_025 ment_tco170 CLK_BASE->SPI0_SDO_MGPIO6A_H2F_B+3.494
pragma attribute MSS_025 ment_tco171 CLK_BASE->SPI0_SDO_USBA_STP_MGPIO6A_OE+5.005
pragma attribute MSS_025 ment_tco172 CLK_BASE->SPI0_SDO_USBA_STP_MGPIO6A_OUT+5.220
pragma attribute MSS_025 ment_tco173 CLK_BASE->SPI0_SS0_MGPIO7A_H2F_A+3.367
pragma attribute MSS_025 ment_tco174 CLK_BASE->SPI0_SS0_MGPIO7A_H2F_B+3.467
pragma attribute MSS_025 ment_tco175 CLK_BASE->SPI0_SS1_MGPIO8A_H2F_A+3.499
pragma attribute MSS_025 ment_tco176 CLK_BASE->SPI0_SS1_MGPIO8A_H2F_B+3.524
pragma attribute MSS_025 ment_tco177 CLK_BASE->SPI0_SS2_MGPIO9A_H2F_A+3.334
pragma attribute MSS_025 ment_tco178 CLK_BASE->SPI0_SS2_MGPIO9A_H2F_B+3.361
pragma attribute MSS_025 ment_tco179 CLK_BASE->SPI0_SS3_MGPIO10A_H2F_A+3.390
pragma attribute MSS_025 ment_tco180 CLK_BASE->SPI0_SS3_MGPIO10A_H2F_B+3.446
pragma attribute MSS_025 ment_tco181 CLK_BASE->SPI0_SS4_MGPIO19A_H2F_A+3.529
pragma attribute MSS_025 ment_tco182 CLK_BASE->SPI0_SS5_MGPIO20A_H2F_A+3.217
pragma attribute MSS_025 ment_tco183 CLK_BASE->SPI0_SS6_MGPIO21A_H2F_A+3.402
pragma attribute MSS_025 ment_tco184 CLK_BASE->SPI0_SS7_MGPIO22A_H2F_A+3.630
pragma attribute MSS_025 ment_tco185 CLK_BASE->SPI1_SDI_MGPIO11A_H2F_A+3.584
pragma attribute MSS_025 ment_tco186 CLK_BASE->SPI1_SDI_MGPIO11A_H2F_B+3.903
pragma attribute MSS_025 ment_tco187 CLK_BASE->SPI1_SDO_MGPIO12A_H2F_A+3.223
pragma attribute MSS_025 ment_tco188 CLK_BASE->SPI1_SDO_MGPIO12A_H2F_B+3.372
pragma attribute MSS_025 ment_tco189 CLK_BASE->SPI1_SDO_MGPIO12A_OE+5.380
pragma attribute MSS_025 ment_tco190 CLK_BASE->SPI1_SDO_MGPIO12A_OUT+5.553
pragma attribute MSS_025 ment_tco191 CLK_BASE->SPI1_SS0_MGPIO13A_H2F_A+3.832
pragma attribute MSS_025 ment_tco192 CLK_BASE->SPI1_SS0_MGPIO13A_H2F_B+4.024
pragma attribute MSS_025 ment_tco193 CLK_BASE->SPI1_SS1_MGPIO14A_H2F_A+3.365
pragma attribute MSS_025 ment_tco194 CLK_BASE->SPI1_SS1_MGPIO14A_H2F_B+3.235
pragma attribute MSS_025 ment_tco195 CLK_BASE->SPI1_SS2_MGPIO15A_H2F_A+3.407
pragma attribute MSS_025 ment_tco196 CLK_BASE->SPI1_SS2_MGPIO15A_H2F_B+3.255
pragma attribute MSS_025 ment_tco197 CLK_BASE->SPI1_SS3_MGPIO16A_H2F_A+3.287
pragma attribute MSS_025 ment_tco198 CLK_BASE->SPI1_SS3_MGPIO16A_H2F_B+3.347
pragma attribute MSS_025 ment_tco199 CLK_BASE->SPI1_SS4_MGPIO17A_H2F_A+3.654
pragma attribute MSS_025 ment_tco200 CLK_BASE->SPI1_SS5_MGPIO18A_H2F_A+3.351
pragma attribute MSS_025 ment_tco201 CLK_BASE->SPI1_SS6_MGPIO23A_H2F_A+3.465
pragma attribute MSS_025 ment_tco202 CLK_BASE->SPI1_SS7_MGPIO24A_H2F_A+3.411
*/
/* synthesis black_box black_box_pad ="" */
 ;
output CAN_RXBUS_MGPIO3A_H2F_A;
output CAN_RXBUS_MGPIO3A_H2F_B;
output CAN_TX_EBL_MGPIO4A_H2F_A;
output CAN_TX_EBL_MGPIO4A_H2F_B;
output CAN_TXBUS_MGPIO2A_H2F_A;
output CAN_TXBUS_MGPIO2A_H2F_B;
output CLK_CONFIG_APB;
output COMMS_INT;
output CONFIG_PRESET_N;
output [7:0] EDAC_ERROR;
output [31:0] F_FM0_RDATA;
output F_FM0_READYOUT;
output F_FM0_RESP;
output [31:0] F_HM0_ADDR;
output F_HM0_ENABLE;
output F_HM0_SEL;
output [1:0] F_HM0_SIZE;
output F_HM0_TRANS1;
output [31:0] F_HM0_WDATA;
output F_HM0_WRITE;
output FAB_CHRGVBUS;
output FAB_DISCHRGVBUS;
output FAB_DMPULLDOWN;
output FAB_DPPULLDOWN;
output FAB_DRVVBUS;
output FAB_IDPULLUP;
output [1:0] FAB_OPMODE;
output FAB_SUSPENDM;
output FAB_TERMSEL;
output FAB_TXVALID;
output [3:0] FAB_VCONTROL;
output FAB_VCONTROLLOADM;
output [1:0] FAB_XCVRSEL;
output [7:0] FAB_XDATAOUT;
output FACC_GLMUX_SEL;
output [1:0] FIC32_0_MASTER;
output [1:0] FIC32_1_MASTER;
output FPGA_RESET_N;
output GTX_CLK;
output [15:0] H2F_INTERRUPT;
output H2F_NMI;
output H2FCALIB;
output I2C0_SCL_MGPIO31B_H2F_A;
output I2C0_SCL_MGPIO31B_H2F_B;
output I2C0_SDA_MGPIO30B_H2F_A;
output I2C0_SDA_MGPIO30B_H2F_B;
output I2C1_SCL_MGPIO1A_H2F_A;
output I2C1_SCL_MGPIO1A_H2F_B;
output I2C1_SDA_MGPIO0A_H2F_A;
output I2C1_SDA_MGPIO0A_H2F_B;
output MDCF;
output MDOENF;
output MDOF;
output MMUART0_CTS_MGPIO19B_H2F_A;
output MMUART0_CTS_MGPIO19B_H2F_B;
output MMUART0_DCD_MGPIO22B_H2F_A;
output MMUART0_DCD_MGPIO22B_H2F_B;
output MMUART0_DSR_MGPIO20B_H2F_A;
output MMUART0_DSR_MGPIO20B_H2F_B;
output MMUART0_DTR_MGPIO18B_H2F_A;
output MMUART0_DTR_MGPIO18B_H2F_B;
output MMUART0_RI_MGPIO21B_H2F_A;
output MMUART0_RI_MGPIO21B_H2F_B;
output MMUART0_RTS_MGPIO17B_H2F_A;
output MMUART0_RTS_MGPIO17B_H2F_B;
output MMUART0_RXD_MGPIO28B_H2F_A;
output MMUART0_RXD_MGPIO28B_H2F_B;
output MMUART0_SCK_MGPIO29B_H2F_A;
output MMUART0_SCK_MGPIO29B_H2F_B;
output MMUART0_TXD_MGPIO27B_H2F_A;
output MMUART0_TXD_MGPIO27B_H2F_B;
output MMUART1_DTR_MGPIO12B_H2F_A;
output MMUART1_RTS_MGPIO11B_H2F_A;
output MMUART1_RTS_MGPIO11B_H2F_B;
output MMUART1_RXD_MGPIO26B_H2F_A;
output MMUART1_RXD_MGPIO26B_H2F_B;
output MMUART1_SCK_MGPIO25B_H2F_A;
output MMUART1_SCK_MGPIO25B_H2F_B;
output MMUART1_TXD_MGPIO24B_H2F_A;
output MMUART1_TXD_MGPIO24B_H2F_B;
output MPLL_LOCK;
output [15:2] PER2_FABRIC_PADDR;
output PER2_FABRIC_PENABLE;
output PER2_FABRIC_PSEL;
output [31:0] PER2_FABRIC_PWDATA;
output PER2_FABRIC_PWRITE;
output RTC_MATCH;
output SLEEPDEEP;
output SLEEPHOLDACK;
output SLEEPING;
output SMBALERT_NO0;
output SMBALERT_NO1;
output SMBSUS_NO0;
output SMBSUS_NO1;
output SPI0_CLK_OUT;
output SPI0_SDI_MGPIO5A_H2F_A;
output SPI0_SDI_MGPIO5A_H2F_B;
output SPI0_SDO_MGPIO6A_H2F_A;
output SPI0_SDO_MGPIO6A_H2F_B;
output SPI0_SS0_MGPIO7A_H2F_A;
output SPI0_SS0_MGPIO7A_H2F_B;
output SPI0_SS1_MGPIO8A_H2F_A;
output SPI0_SS1_MGPIO8A_H2F_B;
output SPI0_SS2_MGPIO9A_H2F_A;
output SPI0_SS2_MGPIO9A_H2F_B;
output SPI0_SS3_MGPIO10A_H2F_A;
output SPI0_SS3_MGPIO10A_H2F_B;
output SPI0_SS4_MGPIO19A_H2F_A;
output SPI0_SS5_MGPIO20A_H2F_A;
output SPI0_SS6_MGPIO21A_H2F_A;
output SPI0_SS7_MGPIO22A_H2F_A;
output SPI1_CLK_OUT;
output SPI1_SDI_MGPIO11A_H2F_A;
output SPI1_SDI_MGPIO11A_H2F_B;
output SPI1_SDO_MGPIO12A_H2F_A;
output SPI1_SDO_MGPIO12A_H2F_B;
output SPI1_SS0_MGPIO13A_H2F_A;
output SPI1_SS0_MGPIO13A_H2F_B;
output SPI1_SS1_MGPIO14A_H2F_A;
output SPI1_SS1_MGPIO14A_H2F_B;
output SPI1_SS2_MGPIO15A_H2F_A;
output SPI1_SS2_MGPIO15A_H2F_B;
output SPI1_SS3_MGPIO16A_H2F_A;
output SPI1_SS3_MGPIO16A_H2F_B;
output SPI1_SS4_MGPIO17A_H2F_A;
output SPI1_SS5_MGPIO18A_H2F_A;
output SPI1_SS6_MGPIO23A_H2F_A;
output SPI1_SS7_MGPIO24A_H2F_A;
output [9:0] TCGF;
output TRACECLK;
output [3:0] TRACEDATA;
output TX_CLK;
output TX_ENF;
output TX_ERRF;
output TXCTL_EN_RIF;
output [3:0] TXD_RIF;
output [7:0] TXDF;
output TXEV;
output WDOGTIMEOUT;
output F_ARREADY_HREADYOUT1;
output F_AWREADY_HREADYOUT0;
output [3:0] F_BID;
output [1:0] F_BRESP_HRESP0;
output F_BVALID;
output [63:0] F_RDATA_HRDATA01;
output [3:0] F_RID;
output F_RLAST;
output [1:0] F_RRESP_HRESP1;
output F_RVALID;
output F_WREADY;
output [15:0] MDDR_FABRIC_PRDATA;
output MDDR_FABRIC_PREADY;
output MDDR_FABRIC_PSLVERR;
input  CAN_RXBUS_F2H_SCP;
input  CAN_TX_EBL_F2H_SCP;
input  CAN_TXBUS_F2H_SCP;
input  COLF;
input  CRSF;
input  [1:0] F2_DMAREADY;
input  [15:0] F2H_INTERRUPT;
input  F2HCALIB;
input  [1:0] F_DMAREADY;
input  [31:0] F_FM0_ADDR;
input  F_FM0_ENABLE;
input  F_FM0_MASTLOCK;
input  F_FM0_READY;
input  F_FM0_SEL;
input  [1:0] F_FM0_SIZE;
input  F_FM0_TRANS1;
input  [31:0] F_FM0_WDATA;
input  F_FM0_WRITE;
input  [31:0] F_HM0_RDATA;
input  F_HM0_READY;
input  F_HM0_RESP;
input  FAB_AVALID;
input  FAB_HOSTDISCON;
input  FAB_IDDIG;
input  [1:0] FAB_LINESTATE;
input  FAB_M3_RESET_N;
input  FAB_PLL_LOCK;
input  FAB_RXACTIVE;
input  FAB_RXERROR;
input  FAB_RXVALID;
input  FAB_RXVALIDH;
input  FAB_SESSEND;
input  FAB_TXREADY;
input  FAB_VBUSVALID;
input  [7:0] FAB_VSTATUS;
input  [7:0] FAB_XDATAIN;
input  GTX_CLKPF;
input  I2C0_BCLK;
input  I2C0_SCL_F2H_SCP;
input  I2C0_SDA_F2H_SCP;
input  I2C1_BCLK;
input  I2C1_SCL_F2H_SCP;
input  I2C1_SDA_F2H_SCP;
input  MDIF;
input  MGPIO0A_F2H_GPIN;
input  MGPIO10A_F2H_GPIN;
input  MGPIO11A_F2H_GPIN;
input  MGPIO11B_F2H_GPIN;
input  MGPIO12A_F2H_GPIN;
input  MGPIO13A_F2H_GPIN;
input  MGPIO14A_F2H_GPIN;
input  MGPIO15A_F2H_GPIN;
input  MGPIO16A_F2H_GPIN;
input  MGPIO17B_F2H_GPIN;
input  MGPIO18B_F2H_GPIN;
input  MGPIO19B_F2H_GPIN;
input  MGPIO1A_F2H_GPIN;
input  MGPIO20B_F2H_GPIN;
input  MGPIO21B_F2H_GPIN;
input  MGPIO22B_F2H_GPIN;
input  MGPIO24B_F2H_GPIN;
input  MGPIO25B_F2H_GPIN;
input  MGPIO26B_F2H_GPIN;
input  MGPIO27B_F2H_GPIN;
input  MGPIO28B_F2H_GPIN;
input  MGPIO29B_F2H_GPIN;
input  MGPIO2A_F2H_GPIN;
input  MGPIO30B_F2H_GPIN;
input  MGPIO31B_F2H_GPIN;
input  MGPIO3A_F2H_GPIN;
input  MGPIO4A_F2H_GPIN;
input  MGPIO5A_F2H_GPIN;
input  MGPIO6A_F2H_GPIN;
input  MGPIO7A_F2H_GPIN;
input  MGPIO8A_F2H_GPIN;
input  MGPIO9A_F2H_GPIN;
input  MMUART0_CTS_F2H_SCP;
input  MMUART0_DCD_F2H_SCP;
input  MMUART0_DSR_F2H_SCP;
input  MMUART0_DTR_F2H_SCP;
input  MMUART0_RI_F2H_SCP;
input  MMUART0_RTS_F2H_SCP;
input  MMUART0_RXD_F2H_SCP;
input  MMUART0_SCK_F2H_SCP;
input  MMUART0_TXD_F2H_SCP;
input  MMUART1_CTS_F2H_SCP;
input  MMUART1_DCD_F2H_SCP;
input  MMUART1_DSR_F2H_SCP;
input  MMUART1_RI_F2H_SCP;
input  MMUART1_RTS_F2H_SCP;
input  MMUART1_RXD_F2H_SCP;
input  MMUART1_SCK_F2H_SCP;
input  MMUART1_TXD_F2H_SCP;
input  [31:0] PER2_FABRIC_PRDATA;
input  PER2_FABRIC_PREADY;
input  PER2_FABRIC_PSLVERR;
input  [9:0] RCGF;
input  RX_CLKPF;
input  RX_DVF;
input  RX_ERRF;
input  RX_EV;
input  [7:0] RXDF;
input  SLEEPHOLDREQ;
input  SMBALERT_NI0;
input  SMBALERT_NI1;
input  SMBSUS_NI0;
input  SMBSUS_NI1;
input  SPI0_CLK_IN;
input  SPI0_SDI_F2H_SCP;
input  SPI0_SDO_F2H_SCP;
input  SPI0_SS0_F2H_SCP;
input  SPI0_SS1_F2H_SCP;
input  SPI0_SS2_F2H_SCP;
input  SPI0_SS3_F2H_SCP;
input  SPI1_CLK_IN;
input  SPI1_SDI_F2H_SCP;
input  SPI1_SDO_F2H_SCP;
input  SPI1_SS0_F2H_SCP;
input  SPI1_SS1_F2H_SCP;
input  SPI1_SS2_F2H_SCP;
input  SPI1_SS3_F2H_SCP;
input  TX_CLKPF;
input  USER_MSS_GPIO_RESET_N;
input  USER_MSS_RESET_N;
input  XCLK_FAB;
input  CLK_BASE;
input  CLK_MDDR_APB;
input  [31:0] F_ARADDR_HADDR1;
input  [1:0] F_ARBURST_HTRANS1;
input  [3:0] F_ARID_HSEL1;
input  [3:0] F_ARLEN_HBURST1;
input  [1:0] F_ARLOCK_HMASTLOCK1;
input  [1:0] F_ARSIZE_HSIZE1;
input  F_ARVALID_HWRITE1;
input  [31:0] F_AWADDR_HADDR0;
input  [1:0] F_AWBURST_HTRANS0;
input  [3:0] F_AWID_HSEL0;
input  [3:0] F_AWLEN_HBURST0;
input  [1:0] F_AWLOCK_HMASTLOCK0;
input  [1:0] F_AWSIZE_HSIZE0;
input  F_AWVALID_HWRITE0;
input  F_BREADY;
input  F_RMW_AXI;
input  F_RREADY;
input  [63:0] F_WDATA_HWDATA01;
input  [3:0] F_WID_HREADY01;
input  F_WLAST;
input  [7:0] F_WSTRB;
input  F_WVALID;
input  FPGA_MDDR_ARESET_N;
input  [10:2] MDDR_FABRIC_PADDR;
input  MDDR_FABRIC_PENABLE;
input  MDDR_FABRIC_PSEL;
input  [15:0] MDDR_FABRIC_PWDATA;
input  MDDR_FABRIC_PWRITE;
input  PRESET_N;
input  CAN_RXBUS_USBA_DATA1_MGPIO3A_IN;
input  CAN_TX_EBL_USBA_DATA2_MGPIO4A_IN;
input  CAN_TXBUS_USBA_DATA0_MGPIO2A_IN;
input  [2:0] DM_IN;
input  [17:0] DRAM_DQ_IN;
input  [2:0] DRAM_DQS_IN;
input  [1:0] DRAM_FIFO_WE_IN;
input  I2C0_SCL_USBC_DATA1_MGPIO31B_IN;
input  I2C0_SDA_USBC_DATA0_MGPIO30B_IN;
input  I2C1_SCL_USBA_DATA4_MGPIO1A_IN;
input  I2C1_SDA_USBA_DATA3_MGPIO0A_IN;
input  MGPIO25A_IN;
input  MGPIO26A_IN;
input  MMUART0_CTS_USBC_DATA7_MGPIO19B_IN;
input  MMUART0_DCD_MGPIO22B_IN;
input  MMUART0_DSR_MGPIO20B_IN;
input  MMUART0_DTR_USBC_DATA6_MGPIO18B_IN;
input  MMUART0_RI_MGPIO21B_IN;
input  MMUART0_RTS_USBC_DATA5_MGPIO17B_IN;
input  MMUART0_RXD_USBC_STP_MGPIO28B_IN;
input  MMUART0_SCK_USBC_NXT_MGPIO29B_IN;
input  MMUART0_TXD_USBC_DIR_MGPIO27B_IN;
input  MMUART1_CTS_MGPIO13B_IN;
input  MMUART1_DCD_MGPIO16B_IN;
input  MMUART1_DSR_MGPIO14B_IN;
input  MMUART1_DTR_MGPIO12B_IN;
input  MMUART1_RI_MGPIO15B_IN;
input  MMUART1_RTS_MGPIO11B_IN;
input  MMUART1_RXD_USBC_DATA3_MGPIO26B_IN;
input  MMUART1_SCK_USBC_DATA4_MGPIO25B_IN;
input  MMUART1_TXD_USBC_DATA2_MGPIO24B_IN;
input  RGMII_GTX_CLK_RMII_CLK_USBB_XCLK_IN;
input  RGMII_MDC_RMII_MDC_IN;
input  RGMII_MDIO_RMII_MDIO_USBB_DATA7_IN;
input  RGMII_RX_CLK_IN;
input  RGMII_RX_CTL_RMII_CRS_DV_USBB_DATA2_IN;
input  RGMII_RXD0_RMII_RXD0_USBB_DATA0_IN;
input  RGMII_RXD1_RMII_RXD1_USBB_DATA1_IN;
input  RGMII_RXD2_RMII_RX_ER_USBB_DATA3_IN;
input  RGMII_RXD3_USBB_DATA4_IN;
input  RGMII_TX_CLK_IN;
input  RGMII_TX_CTL_RMII_TX_EN_USBB_NXT_IN;
input  RGMII_TXD0_RMII_TXD0_USBB_DIR_IN;
input  RGMII_TXD1_RMII_TXD1_USBB_STP_IN;
input  RGMII_TXD2_USBB_DATA5_IN;
input  RGMII_TXD3_USBB_DATA6_IN;
input  SPI0_SCK_USBA_XCLK_IN;
input  SPI0_SDI_USBA_DIR_MGPIO5A_IN;
input  SPI0_SDO_USBA_STP_MGPIO6A_IN;
input  SPI0_SS0_USBA_NXT_MGPIO7A_IN;
input  SPI0_SS1_USBA_DATA5_MGPIO8A_IN;
input  SPI0_SS2_USBA_DATA6_MGPIO9A_IN;
input  SPI0_SS3_USBA_DATA7_MGPIO10A_IN;
input  SPI0_SS4_MGPIO19A_IN;
input  SPI0_SS5_MGPIO20A_IN;
input  SPI0_SS6_MGPIO21A_IN;
input  SPI0_SS7_MGPIO22A_IN;
input  SPI1_SCK_IN;
input  SPI1_SDI_MGPIO11A_IN;
input  SPI1_SDO_MGPIO12A_IN;
input  SPI1_SS0_MGPIO13A_IN;
input  SPI1_SS1_MGPIO14A_IN;
input  SPI1_SS2_MGPIO15A_IN;
input  SPI1_SS3_MGPIO16A_IN;
input  SPI1_SS4_MGPIO17A_IN;
input  SPI1_SS5_MGPIO18A_IN;
input  SPI1_SS6_MGPIO23A_IN;
input  SPI1_SS7_MGPIO24A_IN;
input  USBC_XCLK_IN;
output CAN_RXBUS_USBA_DATA1_MGPIO3A_OUT;
output CAN_TX_EBL_USBA_DATA2_MGPIO4A_OUT;
output CAN_TXBUS_USBA_DATA0_MGPIO2A_OUT;
output [15:0] DRAM_ADDR;
output [2:0] DRAM_BA;
output DRAM_CASN;
output DRAM_CKE;
output DRAM_CLK;
output DRAM_CSN;
output [2:0] DRAM_DM_RDQS_OUT;
output [17:0] DRAM_DQ_OUT;
output [2:0] DRAM_DQS_OUT;
output [1:0] DRAM_FIFO_WE_OUT;
output DRAM_ODT;
output DRAM_RASN;
output DRAM_RSTN;
output DRAM_WEN;
output I2C0_SCL_USBC_DATA1_MGPIO31B_OUT;
output I2C0_SDA_USBC_DATA0_MGPIO30B_OUT;
output I2C1_SCL_USBA_DATA4_MGPIO1A_OUT;
output I2C1_SDA_USBA_DATA3_MGPIO0A_OUT;
output MGPIO25A_OUT;
output MGPIO26A_OUT;
output MMUART0_CTS_USBC_DATA7_MGPIO19B_OUT;
output MMUART0_DCD_MGPIO22B_OUT;
output MMUART0_DSR_MGPIO20B_OUT;
output MMUART0_DTR_USBC_DATA6_MGPIO18B_OUT;
output MMUART0_RI_MGPIO21B_OUT;
output MMUART0_RTS_USBC_DATA5_MGPIO17B_OUT;
output MMUART0_RXD_USBC_STP_MGPIO28B_OUT;
output MMUART0_SCK_USBC_NXT_MGPIO29B_OUT;
output MMUART0_TXD_USBC_DIR_MGPIO27B_OUT;
output MMUART1_CTS_MGPIO13B_OUT;
output MMUART1_DCD_MGPIO16B_OUT;
output MMUART1_DSR_MGPIO14B_OUT;
output MMUART1_DTR_MGPIO12B_OUT;
output MMUART1_RI_MGPIO15B_OUT;
output MMUART1_RTS_MGPIO11B_OUT;
output MMUART1_RXD_USBC_DATA3_MGPIO26B_OUT;
output MMUART1_SCK_USBC_DATA4_MGPIO25B_OUT;
output MMUART1_TXD_USBC_DATA2_MGPIO24B_OUT;
output RGMII_GTX_CLK_RMII_CLK_USBB_XCLK_OUT;
output RGMII_MDC_RMII_MDC_OUT;
output RGMII_MDIO_RMII_MDIO_USBB_DATA7_OUT;
output RGMII_RX_CLK_OUT;
output RGMII_RX_CTL_RMII_CRS_DV_USBB_DATA2_OUT;
output RGMII_RXD0_RMII_RXD0_USBB_DATA0_OUT;
output RGMII_RXD1_RMII_RXD1_USBB_DATA1_OUT;
output RGMII_RXD2_RMII_RX_ER_USBB_DATA3_OUT;
output RGMII_RXD3_USBB_DATA4_OUT;
output RGMII_TX_CLK_OUT;
output RGMII_TX_CTL_RMII_TX_EN_USBB_NXT_OUT;
output RGMII_TXD0_RMII_TXD0_USBB_DIR_OUT;
output RGMII_TXD1_RMII_TXD1_USBB_STP_OUT;
output RGMII_TXD2_USBB_DATA5_OUT;
output RGMII_TXD3_USBB_DATA6_OUT;
output SPI0_SCK_USBA_XCLK_OUT;
output SPI0_SDI_USBA_DIR_MGPIO5A_OUT;
output SPI0_SDO_USBA_STP_MGPIO6A_OUT;
output SPI0_SS0_USBA_NXT_MGPIO7A_OUT;
output SPI0_SS1_USBA_DATA5_MGPIO8A_OUT;
output SPI0_SS2_USBA_DATA6_MGPIO9A_OUT;
output SPI0_SS3_USBA_DATA7_MGPIO10A_OUT;
output SPI0_SS4_MGPIO19A_OUT;
output SPI0_SS5_MGPIO20A_OUT;
output SPI0_SS6_MGPIO21A_OUT;
output SPI0_SS7_MGPIO22A_OUT;
output SPI1_SCK_OUT;
output SPI1_SDI_MGPIO11A_OUT;
output SPI1_SDO_MGPIO12A_OUT;
output SPI1_SS0_MGPIO13A_OUT;
output SPI1_SS1_MGPIO14A_OUT;
output SPI1_SS2_MGPIO15A_OUT;
output SPI1_SS3_MGPIO16A_OUT;
output SPI1_SS4_MGPIO17A_OUT;
output SPI1_SS5_MGPIO18A_OUT;
output SPI1_SS6_MGPIO23A_OUT;
output SPI1_SS7_MGPIO24A_OUT;
output USBC_XCLK_OUT;
output CAN_RXBUS_USBA_DATA1_MGPIO3A_OE;
output CAN_TX_EBL_USBA_DATA2_MGPIO4A_OE;
output CAN_TXBUS_USBA_DATA0_MGPIO2A_OE;
output [2:0] DM_OE;
output [17:0] DRAM_DQ_OE;
output [2:0] DRAM_DQS_OE;
output I2C0_SCL_USBC_DATA1_MGPIO31B_OE;
output I2C0_SDA_USBC_DATA0_MGPIO30B_OE;
output I2C1_SCL_USBA_DATA4_MGPIO1A_OE;
output I2C1_SDA_USBA_DATA3_MGPIO0A_OE;
output MGPIO25A_OE;
output MGPIO26A_OE;
output MMUART0_CTS_USBC_DATA7_MGPIO19B_OE;
output MMUART0_DCD_MGPIO22B_OE;
output MMUART0_DSR_MGPIO20B_OE;
output MMUART0_DTR_USBC_DATA6_MGPIO18B_OE;
output MMUART0_RI_MGPIO21B_OE;
output MMUART0_RTS_USBC_DATA5_MGPIO17B_OE;
output MMUART0_RXD_USBC_STP_MGPIO28B_OE;
output MMUART0_SCK_USBC_NXT_MGPIO29B_OE;
output MMUART0_TXD_USBC_DIR_MGPIO27B_OE;
output MMUART1_CTS_MGPIO13B_OE;
output MMUART1_DCD_MGPIO16B_OE;
output MMUART1_DSR_MGPIO14B_OE;
output MMUART1_DTR_MGPIO12B_OE;
output MMUART1_RI_MGPIO15B_OE;
output MMUART1_RTS_MGPIO11B_OE;
output MMUART1_RXD_USBC_DATA3_MGPIO26B_OE;
output MMUART1_SCK_USBC_DATA4_MGPIO25B_OE;
output MMUART1_TXD_USBC_DATA2_MGPIO24B_OE;
output RGMII_GTX_CLK_RMII_CLK_USBB_XCLK_OE;
output RGMII_MDC_RMII_MDC_OE;
output RGMII_MDIO_RMII_MDIO_USBB_DATA7_OE;
output RGMII_RX_CLK_OE;
output RGMII_RX_CTL_RMII_CRS_DV_USBB_DATA2_OE;
output RGMII_RXD0_RMII_RXD0_USBB_DATA0_OE;
output RGMII_RXD1_RMII_RXD1_USBB_DATA1_OE;
output RGMII_RXD2_RMII_RX_ER_USBB_DATA3_OE;
output RGMII_RXD3_USBB_DATA4_OE;
output RGMII_TX_CLK_OE;
output RGMII_TX_CTL_RMII_TX_EN_USBB_NXT_OE;
output RGMII_TXD0_RMII_TXD0_USBB_DIR_OE;
output RGMII_TXD1_RMII_TXD1_USBB_STP_OE;
output RGMII_TXD2_USBB_DATA5_OE;
output RGMII_TXD3_USBB_DATA6_OE;
output SPI0_SCK_USBA_XCLK_OE;
output SPI0_SDI_USBA_DIR_MGPIO5A_OE;
output SPI0_SDO_USBA_STP_MGPIO6A_OE;
output SPI0_SS0_USBA_NXT_MGPIO7A_OE;
output SPI0_SS1_USBA_DATA5_MGPIO8A_OE;
output SPI0_SS2_USBA_DATA6_MGPIO9A_OE;
output SPI0_SS3_USBA_DATA7_MGPIO10A_OE;
output SPI0_SS4_MGPIO19A_OE;
output SPI0_SS5_MGPIO20A_OE;
output SPI0_SS6_MGPIO21A_OE;
output SPI0_SS7_MGPIO22A_OE;
output SPI1_SCK_OE;
output SPI1_SDI_MGPIO11A_OE;
output SPI1_SDO_MGPIO12A_OE;
output SPI1_SS0_MGPIO13A_OE;
output SPI1_SS1_MGPIO14A_OE;
output SPI1_SS2_MGPIO15A_OE;
output SPI1_SS3_MGPIO16A_OE;
output SPI1_SS4_MGPIO17A_OE;
output SPI1_SS5_MGPIO18A_OE;
output SPI1_SS6_MGPIO23A_OE;
output SPI1_SS7_MGPIO24A_OE;
output USBC_XCLK_OE;
parameter INIT = 'h0;
parameter ACT_UBITS = 'h0;
parameter MEMORYFILE = "";
parameter RTC_MAIN_XTL_FREQ = 0.0;
parameter RTC_MAIN_XTL_MODE = "";
parameter DDR_CLK_FREQ = 0.0;

endmodule
