wangk2017/krv_m0/src/rtl/apb/apb3.v

//////////////////////////////////////////////////////////////////////
// Created by SmartDesign Sat Nov 10 04:33:15 2018
// Version: v11.9 SP1 11.9.1.0
//////////////////////////////////////////////////////////////////////

`timescale 1ns / 100ps

// apb3
module apb3(
    // Inputs
    PADDR,
    PENABLE,
    PRDATAS1,
    PRDATAS2,
    PRDATAS3,
    PRDATAS4,
    PREADYS1,
    PREADYS2,
    PREADYS3,
    PREADYS4,
    PSEL,
    PSLVERRS1,
    PSLVERRS2,
    PSLVERRS3,
    PSLVERRS4,
    PWDATA,
    PWRITE,
    // Outputs
    PADDRS_1,
    PENABLES_1,
    PRDATA,
    PREADY,
    PSELS1,
    PSELS2,
    PSELS3,
    PSELS4,
    PSLVERR,
    PWDATAS_1,
    PWRITES_1
);

//--------------------------------------------------------------------
// Input
//--------------------------------------------------------------------
input  [31:0] PADDR;
input         PENABLE;
input  [31:0] PRDATAS1;
input  [31:0] PRDATAS2;
input  [31:0] PRDATAS3;
input  [31:0] PRDATAS4;
input         PREADYS1;
input         PREADYS2;
input         PREADYS3;
input         PREADYS4;
input         PSEL;
input         PSLVERRS1;
input         PSLVERRS2;
input         PSLVERRS3;
input         PSLVERRS4;
input  [31:0] PWDATA;
input         PWRITE;
//--------------------------------------------------------------------
// Output
//--------------------------------------------------------------------
output [31:0] PADDRS_1;
output        PENABLES_1;
output [31:0] PRDATA;
output        PREADY;
output        PSELS1;
output        PSELS2;
output        PSELS3;
output        PSELS4;
output        PSLVERR;
output [31:0] PWDATAS_1;
output        PWRITES_1;
//--------------------------------------------------------------------
// Nets
//--------------------------------------------------------------------
wire   [31:0] PADDR;
wire          PENABLE;
wire   [31:0] APB3mmaster_PRDATA;
wire          APB3mmaster_PREADY;
wire          PSEL;
wire          APB3mmaster_PSLVERR;
wire   [31:0] PWDATA;
wire          PWRITE;
wire   [31:0] APBmslave1_0_PADDR;
wire          APBmslave1_0_PENABLE;
wire   [31:0] PRDATAS1;
wire          PREADYS1;
wire          APBmslave1_0_PSELx;
wire          PSLVERRS1;
wire   [31:0] APBmslave1_0_PWDATA;
wire          APBmslave1_0_PWRITE;
wire   [31:0] PRDATAS2;
wire          PREADYS2;
wire          APBmslave2_0_PSELx;
wire          PSLVERRS2;
wire   [31:0] PRDATAS3;
wire          PREADYS3;
wire          APBmslave3_0_PSELx;
wire          PSLVERRS3;
wire   [31:0] PRDATAS4;
wire          PREADYS4;
wire          APBmslave4_0_PSELx;
wire          PSLVERRS4;
wire   [31:0] APB3mmaster_PRDATA_net_0;
wire          APB3mmaster_PREADY_net_0;
wire          APB3mmaster_PSLVERR_net_0;
wire   [31:0] APBmslave1_0_PADDR_net_0;
wire          APBmslave1_0_PSELx_net_0;
wire          APBmslave1_0_PENABLE_net_0;
wire          APBmslave1_0_PWRITE_net_0;
wire   [31:0] APBmslave1_0_PWDATA_net_0;
wire          APBmslave2_0_PSELx_net_0;
wire          APBmslave3_0_PSELx_net_0;
wire          APBmslave4_0_PSELx_net_0;
//--------------------------------------------------------------------
// TiedOff Nets
//--------------------------------------------------------------------
wire          GND_net;
wire          VCC_net;
wire   [31:0] IADDR_const_net_0;
wire   [31:0] PRDATAS0_const_net_0;
wire   [31:0] PRDATAS5_const_net_0;
wire   [31:0] PRDATAS6_const_net_0;
wire   [31:0] PRDATAS7_const_net_0;
wire   [31:0] PRDATAS8_const_net_0;
wire   [31:0] PRDATAS9_const_net_0;
wire   [31:0] PRDATAS10_const_net_0;
wire   [31:0] PRDATAS11_const_net_0;
wire   [31:0] PRDATAS12_const_net_0;
wire   [31:0] PRDATAS13_const_net_0;
wire   [31:0] PRDATAS14_const_net_0;
wire   [31:0] PRDATAS15_const_net_0;
wire   [31:0] PRDATAS16_const_net_0;
//--------------------------------------------------------------------
// Constant assignments
//--------------------------------------------------------------------
assign GND_net               = 1'b0;
assign VCC_net               = 1'b1;
assign IADDR_const_net_0     = 32'h00000000;
assign PRDATAS0_const_net_0  = 32'h00000000;
assign PRDATAS5_const_net_0  = 32'h00000000;
assign PRDATAS6_const_net_0  = 32'h00000000;
assign PRDATAS7_const_net_0  = 32'h00000000;
assign PRDATAS8_const_net_0  = 32'h00000000;
assign PRDATAS9_const_net_0  = 32'h00000000;
assign PRDATAS10_const_net_0 = 32'h00000000;
assign PRDATAS11_const_net_0 = 32'h00000000;
assign PRDATAS12_const_net_0 = 32'h00000000;
assign PRDATAS13_const_net_0 = 32'h00000000;
assign PRDATAS14_const_net_0 = 32'h00000000;
assign PRDATAS15_const_net_0 = 32'h00000000;
assign PRDATAS16_const_net_0 = 32'h00000000;
//--------------------------------------------------------------------
// Top level output port assignments
//--------------------------------------------------------------------
assign APB3mmaster_PRDATA_net_0   = APB3mmaster_PRDATA;
assign PRDATA[31:0]               = APB3mmaster_PRDATA_net_0;
assign APB3mmaster_PREADY_net_0   = APB3mmaster_PREADY;
assign PREADY                     = APB3mmaster_PREADY_net_0;
assign APB3mmaster_PSLVERR_net_0  = APB3mmaster_PSLVERR;
assign PSLVERR                    = APB3mmaster_PSLVERR_net_0;
assign APBmslave1_0_PADDR_net_0   = APBmslave1_0_PADDR;
assign PADDRS_1[31:0]             = APBmslave1_0_PADDR_net_0;
assign APBmslave1_0_PSELx_net_0   = APBmslave1_0_PSELx;
assign PSELS1                     = APBmslave1_0_PSELx_net_0;
assign APBmslave1_0_PENABLE_net_0 = APBmslave1_0_PENABLE;
assign PENABLES_1                 = APBmslave1_0_PENABLE_net_0;
assign APBmslave1_0_PWRITE_net_0  = APBmslave1_0_PWRITE;
assign PWRITES_1                  = APBmslave1_0_PWRITE_net_0;
assign APBmslave1_0_PWDATA_net_0  = APBmslave1_0_PWDATA;
assign PWDATAS_1[31:0]            = APBmslave1_0_PWDATA_net_0;
assign APBmslave2_0_PSELx_net_0   = APBmslave2_0_PSELx;
assign PSELS2                     = APBmslave2_0_PSELx_net_0;
assign APBmslave3_0_PSELx_net_0   = APBmslave3_0_PSELx;
assign PSELS3                     = APBmslave3_0_PSELx_net_0;
assign APBmslave4_0_PSELx_net_0   = APBmslave4_0_PSELx;
assign PSELS4                     = APBmslave4_0_PSELx_net_0;
//--------------------------------------------------------------------
// Component instances
//--------------------------------------------------------------------
//--------CoreAPB3   -   Actel:DirectCore:CoreAPB3:4.1.100
CoreAPB3 #( 
        .APB_DWIDTH      ( 32 ),
        .APBSLOT0ENABLE  ( 0 ),
        .APBSLOT1ENABLE  ( 1 ),
        .APBSLOT2ENABLE  ( 1 ),
        .APBSLOT3ENABLE  ( 1 ),
        .APBSLOT4ENABLE  ( 1 ),
        .APBSLOT5ENABLE  ( 0 ),
        .APBSLOT6ENABLE  ( 0 ),
        .APBSLOT7ENABLE  ( 0 ),
        .APBSLOT8ENABLE  ( 0 ),
        .APBSLOT9ENABLE  ( 0 ),
        .APBSLOT10ENABLE ( 0 ),
        .APBSLOT11ENABLE ( 0 ),
        .APBSLOT12ENABLE ( 0 ),
        .APBSLOT13ENABLE ( 0 ),
        .APBSLOT14ENABLE ( 0 ),
        .APBSLOT15ENABLE ( 0 ),
        .FAMILY          ( 19 ),
        .IADDR_OPTION    ( 0 ),
        .MADDR_BITS      ( 16 ),
        .SC_0            ( 0 ),
        .SC_1            ( 0 ),
        .SC_2            ( 0 ),
        .SC_3            ( 0 ),
        .SC_4            ( 0 ),
        .SC_5            ( 0 ),
        .SC_6            ( 0 ),
        .SC_7            ( 0 ),
        .SC_8            ( 0 ),
        .SC_9            ( 0 ),
        .SC_10           ( 0 ),
        .SC_11           ( 0 ),
        .SC_12           ( 0 ),
        .SC_13           ( 0 ),
        .SC_14           ( 0 ),
        .SC_15           ( 0 ),
        .UPR_NIBBLE_POSN ( 3 ) )
apb3_0(
        // Inputs
        .PRESETN    ( GND_net ), // tied to 1'b0 from definition
        .PCLK       ( GND_net ), // tied to 1'b0 from definition
        .PADDR      ( PADDR ),
        .PWRITE     ( PWRITE ),
        .PENABLE    ( PENABLE ),
        .PWDATA     ( PWDATA ),
        .PSEL       ( PSEL ),
        .PRDATAS0   ( PRDATAS0_const_net_0 ), // tied to 32'h00000000 from definition
        .PREADYS0   ( VCC_net ), // tied to 1'b1 from definition
        .PSLVERRS0  ( GND_net ), // tied to 1'b0 from definition
        .PRDATAS1   ( PRDATAS1 ),
        .PREADYS1   ( PREADYS1 ),
        .PSLVERRS1  ( PSLVERRS1 ),
        .PRDATAS2   ( PRDATAS2 ),
        .PREADYS2   ( PREADYS2 ),
        .PSLVERRS2  ( PSLVERRS2 ),
        .PRDATAS3   ( PRDATAS3 ),
        .PREADYS3   ( PREADYS3 ),
        .PSLVERRS3  ( PSLVERRS3 ),
        .PRDATAS4   ( PRDATAS4 ),
        .PREADYS4   ( PREADYS4 ),
        .PSLVERRS4  ( PSLVERRS4 ),
        .PRDATAS5   ( PRDATAS5_const_net_0 ), // tied to 32'h00000000 from definition
        .PREADYS5   ( VCC_net ), // tied to 1'b1 from definition
        .PSLVERRS5  ( GND_net ), // tied to 1'b0 from definition
        .PRDATAS6   ( PRDATAS6_const_net_0 ), // tied to 32'h00000000 from definition
        .PREADYS6   ( VCC_net ), // tied to 1'b1 from definition
        .PSLVERRS6  ( GND_net ), // tied to 1'b0 from definition
        .PRDATAS7   ( PRDATAS7_const_net_0 ), // tied to 32'h00000000 from definition
        .PREADYS7   ( VCC_net ), // tied to 1'b1 from definition
        .PSLVERRS7  ( GND_net ), // tied to 1'b0 from definition
        .PRDATAS8   ( PRDATAS8_const_net_0 ), // tied to 32'h00000000 from definition
        .PREADYS8   ( VCC_net ), // tied to 1'b1 from definition
        .PSLVERRS8  ( GND_net ), // tied to 1'b0 from definition
        .PRDATAS9   ( PRDATAS9_const_net_0 ), // tied to 32'h00000000 from definition
        .PREADYS9   ( VCC_net ), // tied to 1'b1 from definition
        .PSLVERRS9  ( GND_net ), // tied to 1'b0 from definition
        .PRDATAS10  ( PRDATAS10_const_net_0 ), // tied to 32'h00000000 from definition
        .PREADYS10  ( VCC_net ), // tied to 1'b1 from definition
        .PSLVERRS10 ( GND_net ), // tied to 1'b0 from definition
        .PRDATAS11  ( PRDATAS11_const_net_0 ), // tied to 32'h00000000 from definition
        .PREADYS11  ( VCC_net ), // tied to 1'b1 from definition
        .PSLVERRS11 ( GND_net ), // tied to 1'b0 from definition
        .PRDATAS12  ( PRDATAS12_const_net_0 ), // tied to 32'h00000000 from definition
        .PREADYS12  ( VCC_net ), // tied to 1'b1 from definition
        .PSLVERRS12 ( GND_net ), // tied to 1'b0 from definition
        .PRDATAS13  ( PRDATAS13_const_net_0 ), // tied to 32'h00000000 from definition
        .PREADYS13  ( VCC_net ), // tied to 1'b1 from definition
        .PSLVERRS13 ( GND_net ), // tied to 1'b0 from definition
        .PRDATAS14  ( PRDATAS14_const_net_0 ), // tied to 32'h00000000 from definition
        .PREADYS14  ( VCC_net ), // tied to 1'b1 from definition
        .PSLVERRS14 ( GND_net ), // tied to 1'b0 from definition
        .PRDATAS15  ( PRDATAS15_const_net_0 ), // tied to 32'h00000000 from definition
        .PREADYS15  ( VCC_net ), // tied to 1'b1 from definition
        .PSLVERRS15 ( GND_net ), // tied to 1'b0 from definition
        .PRDATAS16  ( PRDATAS16_const_net_0 ), // tied to 32'h00000000 from definition
        .PREADYS16  ( VCC_net ), // tied to 1'b1 from definition
        .PSLVERRS16 ( GND_net ), // tied to 1'b0 from definition
        .IADDR      ( IADDR_const_net_0 ), // tied to 32'h00000000 from definition
        // Outputs
        .PRDATA     ( APB3mmaster_PRDATA ),
        .PREADY     ( APB3mmaster_PREADY ),
        .PSLVERR    ( APB3mmaster_PSLVERR ),
        .PADDRS     ( APBmslave1_0_PADDR ),
        .PWRITES    ( APBmslave1_0_PWRITE ),
        .PENABLES   ( APBmslave1_0_PENABLE ),
        .PWDATAS    ( APBmslave1_0_PWDATA ),
        .PSELS0     (  ),
        .PSELS1     ( APBmslave1_0_PSELx ),
        .PSELS2     ( APBmslave2_0_PSELx ),
        .PSELS3     ( APBmslave3_0_PSELx ),
        .PSELS4     ( APBmslave4_0_PSELx ),
        .PSELS5     (  ),
        .PSELS6     (  ),
        .PSELS7     (  ),
        .PSELS8     (  ),
        .PSELS9     (  ),
        .PSELS10    (  ),
        .PSELS11    (  ),
        .PSELS12    (  ),
        .PSELS13    (  ),
        .PSELS14    (  ),
        .PSELS15    (  ),
        .PSELS16    (  ) 
        );


endmodule
