wangk2017/krv_m0/(commit log)

2018-11-25 first submit
    [ENVM.cfg, MSS_ENVM_0.cfg, krv_m.stp]
2018-11-28 fix a long timing path/wfi stall
    [core.v, dec.v, fetch.v, trap_ctrl.v]
2018-11-28 fix a branch_taken related timing path/zephyr_phil test_end
    [alu.v, zephyr_phil_debug.v]
2018-12-03 fix a load hazard issue
    [dec.v]
2018-12-18 fix ahb decoder comment
    [ahb_decoder.v]
2018-12-21 hack mepc for timer int during reschedule
